mxnin/github-slideshow/trabalho_pmr3220/figuras/p1_gabarito_maquete.pdf

## PMR3220 – Grupo C – Gabarito 1:1 da maquete (imprimir em escala 100%)

escala: 100 mm

Elo CQ: 39.0 mm entre centros (furo Ø4,2)

Elo LN: 53.9 mm entre centros (furo Ø4,2)

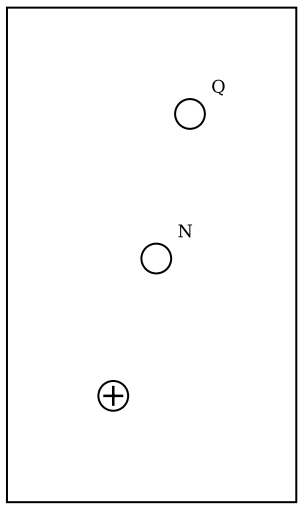
[picture p1: figure]

Placa distal da coxa (+ = origem da base 0)

Placa proximal da perna (+ = origem da base 4, ponto J)

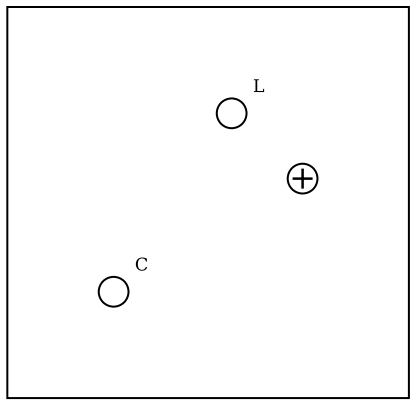
[picture p2: figure]

Coxa e perna nas dimensões medidas (coxa ≈ 375 mm; joelho–tornozelo ≈ 420 mm). Elos CQ e LN em planos diferentes (um de cada lado das placas).
