mxnin/github-slideshow/trabalho_pmr3220/main_parcial.tex

\documentclass[12pt,a4paper,twoside]{article}

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

\lstset{basicstyle=\ttfamily\footnotesize, breaklines=true, frame=single,
        literate={á}{{\'a}}1 {ã}{{\~a}}1 {é}{{\'e}}1 {ç}{{\c{c}}}1 {õ}{{\~o}}1 {í}{{\'i}}1 {ó}{{\'o}}1}

\input{dados/valores_parcial.tex}

\newcommand{\ve}[1]{\bm{#1}}
% --- notacao do metodo matricial (PMR3220) ---
\DeclareMathOperator{\sen}{sen}
\newcommand{\rv}[2]{{}^{#1}\mathbf{r}_{#2}}          % vetor posicao do ponto #2 na base #1
\newcommand{\rvd}[2]{{}^{#1}\dot{\mathbf{r}}_{#2}}
\newcommand{\rvdd}[2]{{}^{#1}\ddot{\mathbf{r}}_{#2}}
\newcommand{\vv}[2]{{}^{#1}\mathbf{v}_{#2}}
\newcommand{\Rmd}[2]{[{}^{#1}\dot R_{#2}]}             % derivadas da matriz de rotacao
\newcommand{\Rmdd}[2]{[{}^{#1}\ddot R_{#2}]}
\newcommand{\Et}{\tilde{\mathbf k}}                   % matriz antissimetrica de k no plano
\newcommand{\Rm}[2]{[{}^{#1}R_{#2}]}                 % matriz de rotacao
\newcommand{\Rot}[2]{\mathrm{Rot}(#1,\,#2)}
\newcommand{\Jm}[1]{[J_{#1}]}
\newcommand{\e}{\mathrm{e}}
\newcommand{\dd}{\,\mathrm{d}}
\newtheorem{hipotese}{Hipótese}
\captionsetup{font=small,labelsep=colon}
\numberwithin{equation}{section}

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

\pagenumbering{roman}
\listoffigures
\clearpage
\listoftables
\clearpage
\tableofcontents
\clearpage
\pagenumbering{arabic}
\setcounter{page}{5}

\section{Introdução}

O movimento do membro inferior humano resulta da interação entre diferentes segmentos
e articulações, sendo o joelho particularmente importante para a mobilidade entre a
coxa e a perna. Entretanto, seu movimento relativo não pode ser rigorosamente
representado por uma simples junta de revolução: no plano sagital, os côndilos
femorais rolam e deslizam sobre o platô tibial, de modo que o centro instantâneo de
rotação (CIR) descreve uma trajetória -- a \emph{centroide} -- em vez de permanecer fixo
\cite{menschik1974,oconnor1989,dathe2016}. Desde \textcite{menschik1974}, essa cinemática
é modelada por um quadrilátero articulado cruzado, formado pelas fibras isométricas
dos ligamentos cruzados anterior (LCA) e posterior (LCP) e pelos segmentos ósseos que
unem suas inserções \cite{oconnor1989,zavatsky1992}.

Nesse contexto, o projeto de próteses e órteses constitui uma aplicação relevante da
teoria de mecanismos, permitindo reproduzir ou auxiliar movimentos do membro inferior
em situações de amputação ou de comprometimento da capacidade motora. Este relatório
parcial trata da primeira etapa do trabalho: o projeto de uma prótese de joelho e
perna capaz de reproduzir o movimento relativo entre a coxa e o conjunto perna--pé por
meio de um quadrilátero articulado plano (\cref{fig:enunciado}). São apresentados a
fundamentação do modelo, a definição da geometria, a aquisição experimental do
movimento em um integrante do grupo e o processamento dos dados que servirá de base
para a síntese dimensional do mecanismo.

\begin{figure}[htbp]
  \centering
  
  \caption{Diagrama cinemático do enunciado: pivôs $C$ e $L$ na coxa e $Q$ e $N$ na perna.}
  \label{fig:enunciado}
\end{figure}

\section{Objetivos}

\begin{itemize}
  \item Desenvolver a síntese dimensional de um mecanismo quadrilátero articulado,
  capaz de reproduzir de forma aproximada o movimento relativo entre a coxa e o
  conjunto perna--pé de uma prótese de membro inferior.
  \item Determinar as dimensões e as posições das articulações do mecanismo, utilizando
  como referência as posições do membro inferior obtidas experimentalmente.
  \item Realizar a análise cinemática de uma órtese para membro inferior, determinando
  as posições, velocidades e acelerações angulares dos segmentos ao longo de um ciclo
  de movimento.
  \item Realizar a análise dinâmica do sistema, determinando os torques necessários nos
  atuadores do joelho e da articulação entre a coxa e o tronco para a execução do
  movimento considerado.
\end{itemize}

Neste relatório parcial são desenvolvidas as etapas preparatórias do primeiro e do
segundo objetivos: a formulação do modelo do quadrilátero e a obtenção, a partir das
medições, do movimento relativo entre a coxa e a perna.

\section{Fundamentação teórica}\label{cap:teoria1}

\subsection{Notação}\label{sec:notacao}

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

\subsection{Síntese do tipo e mobilidade: o quadrilátero articulado}

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

No joelho protético (\cref{fig:enunciado}) o elo fixo é a coxa (pivôs $C$ e $L$),
as manivelas/balancins são $CQ$ e $LN$, e o \emph{acoplador} é a perna (pivôs $Q$ e $N$),
ao qual se fixa rigidamente o pé. Como o acoplador executa um movimento plano geral,
seu CIR relativo à coxa -- o polo $I_{13}$ -- é, pelo teorema de Aronhold--Kennedy, a
intersecção das retas $CQ$ e $LN$ e se desloca à medida que o joelho flexiona, tal como
no joelho natural \cite{norton2010,radcliffe1994}. Joelhos protéticos de quatro barras
exploram essa propriedade: com o CIR alto e posterior na extensão, obtém-se
estabilidade voluntária na fase de apoio; com o CIR migrando na flexão, obtém-se
encurtamento aparente da perna na fase de balanço \cite{radcliffe1994}.

A condição de Grashof classifica o tipo de movimento possível. Sendo $s$ e $l$ os
comprimentos do menor e do maior elo e $p$, $q$ os demais,
\begin{equation}
  s + l \le p + q \quad\Longrightarrow\quad \text{pelo menos um elo dá voltas completas.}
  \label{eq:grashof}
\end{equation}
Na prótese, a flexão útil está limitada a cerca de \SI{120}{\degree}; logo, um mecanismo
não Grashof (triplo balancim) é aceitável, desde que nenhuma configuração de ponto
morto ocorra dentro dessa faixa. A qualidade da transmissão de forças é avaliada pelo
ângulo de transmissão $\mu$ -- ângulo agudo entre o acoplador e o balancim de saída --,
recomendando-se $\mu \ge \SI{30}{\degree}$ \cite{norton2010}.

\subsection{Bases e análise de posição do quadrilátero (cadeia fechada)}\label{sec:cadeia_fechada}

A \cref{fig:quadrilatero} mostra as bases adotadas, seguindo a convenção da
\cref{sec:notacao}. A base $0$ (fixa) está presa à coxa, com origem no centro do joelho em
extensão, $X_0$ para a frente (anterior) e $Y_0$ para cima (proximal). As bases $1$, $2$ e $3$
estão presas, respectivamente, ao elo $CQ$ (origem em $C$, $X_1$ ao longo de $CQ$), ao
acoplador (origem em $Q$, $X_2$ ao longo de $QN$) e ao elo $LN$ (origem em $L$, $X_3$ ao longo
de $LN$). A base $4$ também está presa à perna, com origem no ponto de referência do
joelho e $Y_4$ ao longo do eixo da perna (é a base em que se fazem as medições). Os
comprimentos são $\ell_0 = \overline{CL}$, $\ell_1 = \overline{CQ}$, $\ell_2 = \overline{QN}$ e
$\ell_3 = \overline{LN}$.

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

As matrizes de rotação e as origens das bases são
\begin{gather}
  \Rm{0}{1} = \begin{bmatrix} c_1 & -s_1 \\ s_1 & c_1 \end{bmatrix},\quad
  \Rm{1}{2} = \begin{bmatrix} c_2 & -s_2 \\ s_2 & c_2 \end{bmatrix},\quad
  \Rm{0}{3} = \begin{bmatrix} c_3 & -s_3 \\ s_3 & c_3 \end{bmatrix},\\
  \rv{0}{O_1} = \rv{0}{C},\qquad \rv{1}{O_2} = \begin{bmatrix} \ell_1 \\ 0 \end{bmatrix},\qquad \rv{0}{O_3} = \rv{0}{L},
\end{gather}
com $\rv{2}{N} = [\ell_2\ \ 0]^{\mathsf T}$ e $\rv{3}{N} = [\ell_3\ \ 0]^{\mathsf T}$. O ponto $N$ pertence
simultaneamente ao ramo $0\text{--}1\text{--}2$ e ao ramo $0\text{--}3$ da cadeia. Pelo ramo
$0\text{--}1\text{--}2$, aplica-se \eqref{eq:cadeia} de dentro para fora:
\begin{align*}
  \rv{1}{N} &= \rv{1}{O_2} + \Rm{1}{2}\,\rv{2}{N}
            = \begin{bmatrix} \ell_1 \\ 0 \end{bmatrix} + \begin{bmatrix} c_2 & -s_2 \\ s_2 & c_2 \end{bmatrix}\begin{bmatrix} \ell_2 \\ 0 \end{bmatrix}
            = \begin{bmatrix} \ell_1 + \ell_2 c_2 \\ \ell_2 s_2 \end{bmatrix},\\
  \rv{0}{N} &= \rv{0}{C} + \Rm{0}{1}\,\rv{1}{N}
            = \begin{bmatrix} {}^0x_C + \ell_1 c_1 + \ell_2(c_1c_2 - s_1s_2) \\ {}^0y_C + \ell_1 s_1 + \ell_2(s_1c_2 + c_1s_2) \end{bmatrix},
\end{align*}
e as identidades $c_1c_2 - s_1s_2 = c_{12}$ e $s_1c_2 + c_1s_2 = s_{12}$ simplificam o resultado. Pelo
ramo $0\text{--}3$, $\rv{0}{N} = \rv{0}{L} + \Rm{0}{3}\,\rv{3}{N}$. Igualando os dois ramos, obtém-se a
\emph{equação de fechamento}
\begin{equation}
  \rv{0}{C} + \Rm{0}{1}\Big(\rv{1}{O_2} + \Rm{1}{2}\,\rv{2}{N}\Big) = \rv{0}{L} + \Rm{0}{3}\,\rv{3}{N}
  \;\Longrightarrow\;
  \begin{bmatrix} {}^0x_C + \ell_1 c_1 + \ell_2 c_{12} \\ {}^0y_C + \ell_1 s_1 + \ell_2 s_{12} \end{bmatrix}
  = \begin{bmatrix} {}^0x_L + \ell_3 c_3 \\ {}^0y_L + \ell_3 s_3 \end{bmatrix}.
  \label{eq:fechamento}
\end{equation}
Na prótese, a variável de entrada é a orientação da perna, $\psi = \theta_1 + \theta_2$
(ângulo de $X_2$ em relação a $X_0$), e as incógnitas são $\mathbf q = [\theta_1\ \ \theta_3]^{\mathsf T}$.
Passando todos os termos de \eqref{eq:fechamento} para um lado, com $c_{12} = \cos\psi$ e
$s_{12} = \sen\psi$ conhecidos,
\begin{equation*}
  \mathbf f(\mathbf q) =
  \begin{bmatrix} {}^0x_C + \ell_1 c_1 + \ell_2\cos\psi - {}^0x_L - \ell_3 c_3 \\
                  {}^0y_C + \ell_1 s_1 + \ell_2\sen\psi - {}^0y_L - \ell_3 s_3 \end{bmatrix} = \mathbf 0 ,
\end{equation*}
cujas derivadas parciais em relação a $\theta_1$ e $\theta_3$ formam a matriz jacobiana. A
solução é obtida pelo método de Newton--Raphson,
\begin{equation}
  \mathbf q^{(i+1)} = \mathbf q^{(i)} - [J]^{-1}\,\mathbf f\big(\mathbf q^{(i)}\big),
  \qquad
  [J] = \frac{\partial\mathbf f}{\partial\mathbf q} =
  \begin{bmatrix} -\ell_1 s_1 & \ell_3 s_3 \\ \ell_1 c_1 & -\ell_3 c_3 \end{bmatrix},
  \label{eq:newton}
\end{equation}
partindo da solução do passo anterior, o que mantém o mecanismo no mesmo ramo de
montagem. Como $\det[J] = \ell_1\ell_3\,\sen(\theta_1 - \theta_3)$, a matriz é singular quando
$CQ \parallel LN$ (polo no infinito). Uma vez conhecidos $\theta_1$ e $\theta_3$, o polo
$I_{13}$ (CIR da perna em relação à coxa) é a intersecção dos eixos $X_1$ e $X_3$,
\begin{equation}
  \rv{0}{I} = \rv{0}{C} + \lambda\begin{bmatrix} c_1\\ s_1\end{bmatrix} = \rv{0}{L} + \kappa\begin{bmatrix} c_3\\ s_3\end{bmatrix},
\end{equation}
e o ângulo de transmissão é o ângulo agudo entre $X_2$ e $X_3$, $\mu = |\psi - \theta_3|$
(reduzido a $[0, \SI{90}{\degree}]$).

\section{Metodologia}\label{cap:metodos1}

\subsection{Definição da geometria do mecanismo}

Inicialmente, foi definida uma representação geométrica simplificada do membro
inferior humano, buscando preservar as principais características cinemáticas do
movimento da coxa, da perna e do pé. A coxa, a perna e o pé foram considerados como
elementos rígidos, representados pelas geometrias correspondentes às regiões do membro
inferior. Para representar o movimento relativo entre a coxa e a perna na região do
joelho, foi adotado um mecanismo quadrilátero articulado. A configuração adotada e a
identificação dos pontos utilizados no modelo são apresentadas na \cref{fig:geometria}.

\begin{figure}[htbp]
  \centering
  
  \caption{Geometria adotada para a representação do membro inferior.}
  \label{fig:geometria}
\end{figure}

Na representação adotada, os pontos 1 e 2 estão localizados na região do quadril,
enquanto os pontos 3 e 4 estão posicionados na extremidade inferior da coxa, próxima à
região do joelho. Para a perna, os pontos 5 e 6 estão localizados imediatamente abaixo
do joelho, enquanto os pontos 7 e 9 estão posicionados aproximadamente na região do
tornozelo. O ponto 8 está localizado entre os pontos 7 e 9, contribuindo para a
representação da conexão entre a perna e o pé. Por fim, os pontos 10 e 11 correspondem
às extremidades inferiores da representação do pé.

A escolha de um mecanismo quadrilátero articulado para representar o movimento do
joelho está relacionada à necessidade de reproduzir adequadamente o movimento relativo
observado entre a coxa e a perna. Uma representação mais simples, na qual a coxa e a
perna fossem consideradas elementos rígidos conectados diretamente por uma única junta
de revolução, permitiria descrever apenas uma rotação da perna em torno de um centro
fixo. Nesse caso, os pontos pertencentes à perna descreveriam trajetórias circulares em
relação à coxa, o que constitui uma aproximação limitada do movimento do joelho.

O emprego de um quadrilátero articulado permite obter o movimento relativo entre a
coxa e a perna a partir da combinação das rotações de seus diferentes elos. Dessa
forma, o centro instantâneo do movimento relativo entre os segmentos (o polo $I_{13}$ da
\cref{sec:cadeia_fechada}) pode variar durante a movimentação, permitindo reproduzir
trajetórias mais complexas do que aquelas obtidas por uma única junta de revolução.
Essa característica é particularmente relevante para o problema proposto, uma vez que
o movimento relativo entre a coxa e a perna não pode ser rigorosamente representado
apenas por uma junta de rotação.

A representação do pé por meio de uma geometria triangular foi adotada de maneira
análoga, buscando preservar sua extensão e sua orientação em relação à perna. Uma
representação por um único elemento rígido poderia descrever apenas a distância entre
dois pontos, sem representar simultaneamente diferentes pontos de referência
associados ao pé. A geometria triangular fornece, portanto, uma representação rígida
simplificada da região, possibilitando acompanhar sua posição e orientação durante o
movimento.

Embora os pontos utilizados na aquisição experimental tenham sido definidos próximos
aos vértices das regiões utilizadas na representação geométrica, a localização das
articulações do mecanismo não está necessariamente restrita a esses pontos
experimentais. Articulações localizadas no interior das regiões correspondentes à coxa
e à perna também podem ser consideradas durante a síntese, desde que sejam compatíveis
com a geometria e com o movimento desejado.

\subsection{Aquisição experimental do movimento}\label{sec:aquisicao}

Após a definição da geometria, foram realizadas medições experimentais com o objetivo
de obter as posições dos pontos de interesse ao longo do movimento do membro inferior.
Para isso, um integrante do grupo realizou o movimento com a própria perna, e foi
registrada uma sequência de vídeo com o membro observado lateralmente.

Foram consideradas três configurações principais para caracterizar o movimento. A
configuração inicial corresponde à posição em pé, na qual a coxa, a perna e o pé se
encontram aproximadamente alinhados. A configuração intermediária corresponde a uma
flexão da perna de aproximadamente \SI{90}{\degree} em relação à coxa, mantendo-se a
posição da coxa. Por fim, a configuração final corresponde à condição de maior flexão
observada durante o experimento, na qual a perna se aproxima da coxa. A sequência de
configurações observada durante o movimento é apresentada na \cref{fig:sequencia}.

\begin{figure}[htbp]
  \centering
  
  \caption{Sequência de configurações do membro inferior durante o movimento experimental.}
  \label{fig:sequencia}
\end{figure}

Para o processamento do vídeo foi empregado o software \emph{Tracker} \cite{tracker},
que permite acompanhar a posição de pontos específicos ao longo dos diferentes
\emph{frames} de uma gravação. Foram definidos pontos de referência próximos aos
vértices das regiões utilizadas na representação geométrica da coxa, da perna e do pé.
Esses pontos foram identificados e acompanhados individualmente ao longo do movimento,
permitindo obter suas coordenadas no plano da imagem em função do tempo. A numeração
dos pontos utilizada no rastreamento corresponde à geometria apresentada anteriormente
(\cref{fig:geometria}).

\begin{figure}[htbp]
  \centering
  
  \caption{Rastreamento dos pontos do membro inferior e obtenção das posições no software \emph{Tracker}.}
  \label{fig:tracker}
\end{figure}

A partir do rastreamento, o \emph{Tracker} forneceu as coordenadas $x$ e $y$ dos pontos
acompanhados para os diferentes instantes analisados. Os valores obtidos correspondem,
portanto, às posições dos pontos no plano da imagem (base $im$, com a escala calibrada
em metros), e não diretamente aos comprimentos dos elos do mecanismo. O software também
permitiu visualizar graficamente a evolução temporal dessas coordenadas.

A planilha de dados obtida a partir do rastreamento contém as coordenadas dos onze
pontos para os \emph{frames} 234, 307, 390, 423, 456 e 561 (\cref{tab:tracker}, na
\cref{sec:anexos}). Para a análise do movimento, foram selecionados os \emph{frames}
307, 390, 423 e 456. O \emph{frame} 234 foi utilizado como referência durante a
identificação e numeração dos pontos, enquanto o \emph{frame} 561 foi desconsiderado,
pois corresponde a uma etapa do movimento em que houve auxílio manual para conduzir a
perna.

\subsection{Processamento dos dados}\label{sec:processamento}

As coordenadas do \emph{Tracker} estão na base da imagem. O que interessa ao quadrilátero
do joelho é apenas o movimento \emph{relativo} entre a coxa e a perna; por isso, o
movimento angular do quadril (a rotação da coxa em relação ao tronco, que também ocorre
levemente durante o experimento) foi desconsiderado, e a coxa foi tratada como o elo
fixo do mecanismo. Os dados foram processados em dois passos.

\paragraph{1º passo -- base da coxa em cada quadro.} A base $0$ tem origem no ponto médio
dos marcadores 3 e 4 (extremidade distal da coxa, junto ao joelho) e eixos paralelos aos
da imagem: $X_0$ horizontal, para a frente, e $Y_0$ vertical, para cima. Como a rotação do
quadril é desconsiderada, $\Rm{im}{0} = \Rot{0}{z_0} = I$, e a base da coxa apenas
acompanha a translação da região do joelho entre os quadros. Com
$\rv{im}{O_0} = \tfrac12\big(\rv{im}{3} + \rv{im}{4}\big)$, a mudança de base inversa de
\eqref{eq:mudancabase} fornece as coordenadas de cada marcador $k$ na base da coxa:
\begin{equation}
  \rv{0}{k} = \Rm{im}{0}^{\mathsf T}\big(\rv{im}{k} - \rv{im}{O_0}\big) = \rv{im}{k} - \tfrac12\big(\rv{im}{3} + \rv{im}{4}\big).
\end{equation}
Os marcadores 1 e 2 (quadril) não entram no processamento.

\paragraph{2º passo -- orientação da perna e flexão do joelho.} A perna é representada pelo
segmento que vai do ponto $J$, médio dos marcadores 5 e 6 (logo abaixo do joelho), ao
ponto $P$, marcador 8 (conexão perna--pé). Na base da coxa, sua orientação é
\begin{equation}
  \beta_j = \operatorname{atan2}\big({}^0y_P - {}^0y_J,\ {}^0x_P - {}^0x_J\big),
\end{equation}
e a flexão do joelho no quadro $j$ é medida em relação ao quadro 307 (membro estendido):
\begin{equation}
  \varphi_j = \beta_{307} - \beta_j \pmod{\SI{360}{\degree}} .
\end{equation}

\begin{table}[htbp]
  \centering
  \caption{Posição da perna na base $0$ (coxa) obtida das medições (mm): ponto $J$ (abaixo
  do joelho), ponto $P$ (tornozelo) e comprimento $\overline{JP}$. $\dagger$: quadro não
  utilizado na análise.}
  \label{tab:poses}
  \begin{tabular}{lrrrrrr}
    \toprule
    Quadro & $\varphi$ (\si{\degree}) & ${}^0x_{J}$ & ${}^0y_{J}$ & ${}^0x_{P}$ & ${}^0y_{P}$ & $\overline{JP}$ \\
    \midrule
    \tabelaposes
    \bottomrule
  \end{tabular}
\end{table}

\begin{figure}[htbp]
  \centering
  
  \caption{Marcadores dos quadros selecionados escritos na base da coxa, com origem entre
  os pontos 3 e 4 ($\square$: coxa, $\circ$: perna, $\triangle$: pé; linha: segmento $JP$).}
  \label{fig:medicoes}
\end{figure}

Os quadros selecionados correspondem a flexões de \phiA, \phiB, \phiC{} e
\phiD\si{\degree} (\cref{tab:poses,fig:medicoes}), próximas das configurações inicial
(\SI{0}{\degree}), intermediárias (cerca de \SI{45}{\degree} e \SI{90}{\degree}) e de
máxima flexão. O comprimento do segmento $JP$ varia apenas entre \pernamin{} e
\pernamax~mm, o que confirma a coerência da marcação ao longo do movimento (as
diferenças decorrem dos artefatos de pele e da marcação manual). Observa-se ainda que
o ponto $J$, logo abaixo do joelho, desloca-se cerca de \deslJ~mm em relação à coxa entre
a extensão e a flexão máxima: a perna não gira em torno de um ponto fixo, o que
confirma que uma junta de revolução simples não reproduz o movimento e motiva o uso do
quadrilátero articulado.

\section{Conclusões}

Nesta etapa, foram definidos a geometria de representação do membro inferior e o
modelo do joelho protético como quadrilátero articulado, formulado pelo método
matricial. O movimento do membro de um integrante do grupo foi filmado e rastreado no
\emph{Tracker}, e os dados foram escritos na base da coxa, desconsiderando o movimento
angular do quadril. Os quatro quadros selecionados cobrem flexões do joelho de
\phiA{} a \phiD\si{\degree}, e o deslocamento de cerca de \deslJ~mm da região proximal
da perna em relação à coxa confirma que o movimento relativo não é uma rotação pura.

As próximas etapas são: a síntese dimensional do quadrilátero a partir das posições
medidas, a construção da maquete e a análise cinemática e dinâmica da órtese.

\section{Materiais e anexos}\label{sec:anexos}

Os arquivos utilizados na aquisição e no tratamento dos dados experimentais são
disponibilizados juntamente com o relatório, incluindo o arquivo do projeto utilizado
no software \emph{Tracker}, a planilha com as coordenadas obtidas durante o rastreamento
e o programa em Python usado no processamento (\texttt{scripts/parte1\_parcial.py}).

\subsection{Dados experimentais obtidos pelo \emph{Tracker}}

A tabela a seguir apresenta as coordenadas cartesianas dos onze pontos rastreados para os
\emph{frames} registrados durante o experimento. Os valores correspondem diretamente aos
dados obtidos no arquivo de saída utilizado para a organização dos resultados
experimentais.

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

\clearpage
\printbibliography[heading=bibintoc,title={Referências}]

\end{document}
