mxnin/github-slideshow/trabalho_pmr3220/figuras/p1_erro_mu.pdf

### Ângulos nas articulações móveis

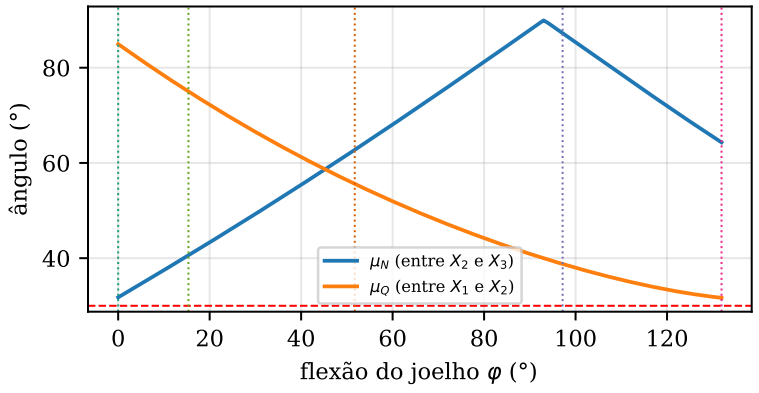
[picture p25: figure]
flexão do joelho φ (°); ângulo (°); (entre X2 e X3); (entre X1 e X2)
