mxnin/github-slideshow/autocad/joelho-4-barras/preview-A3.png

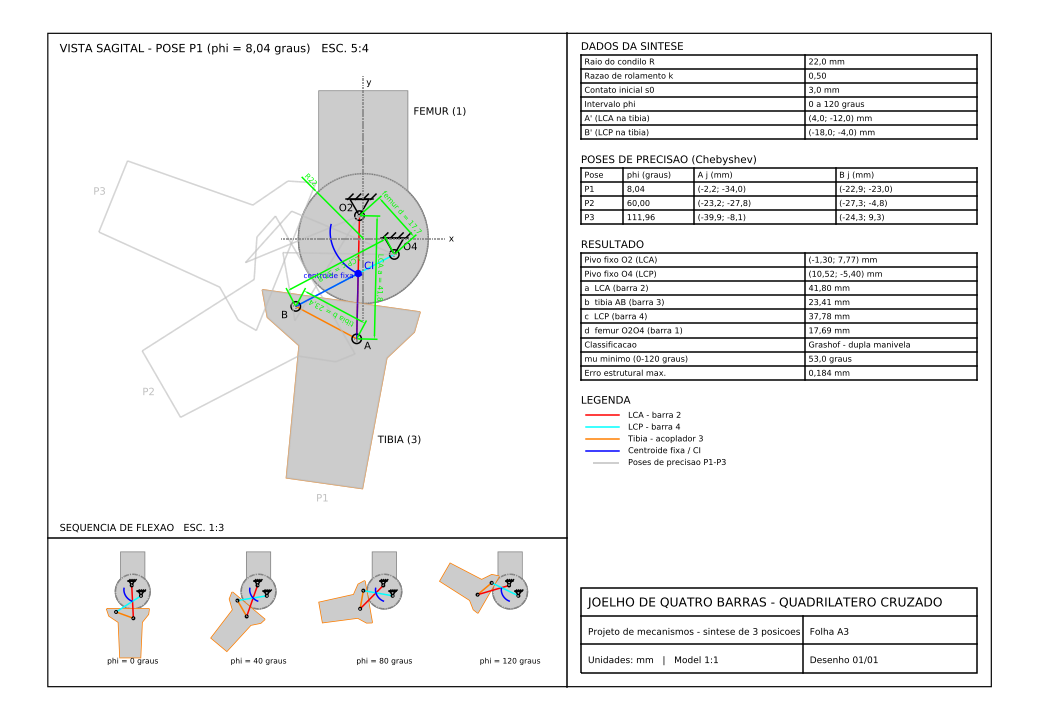
autocad/joelho-4-barras/preview-A3.png
