mxnin/github-slideshow/autocad/joelho-4-barras/joelho-4-barras.dxf

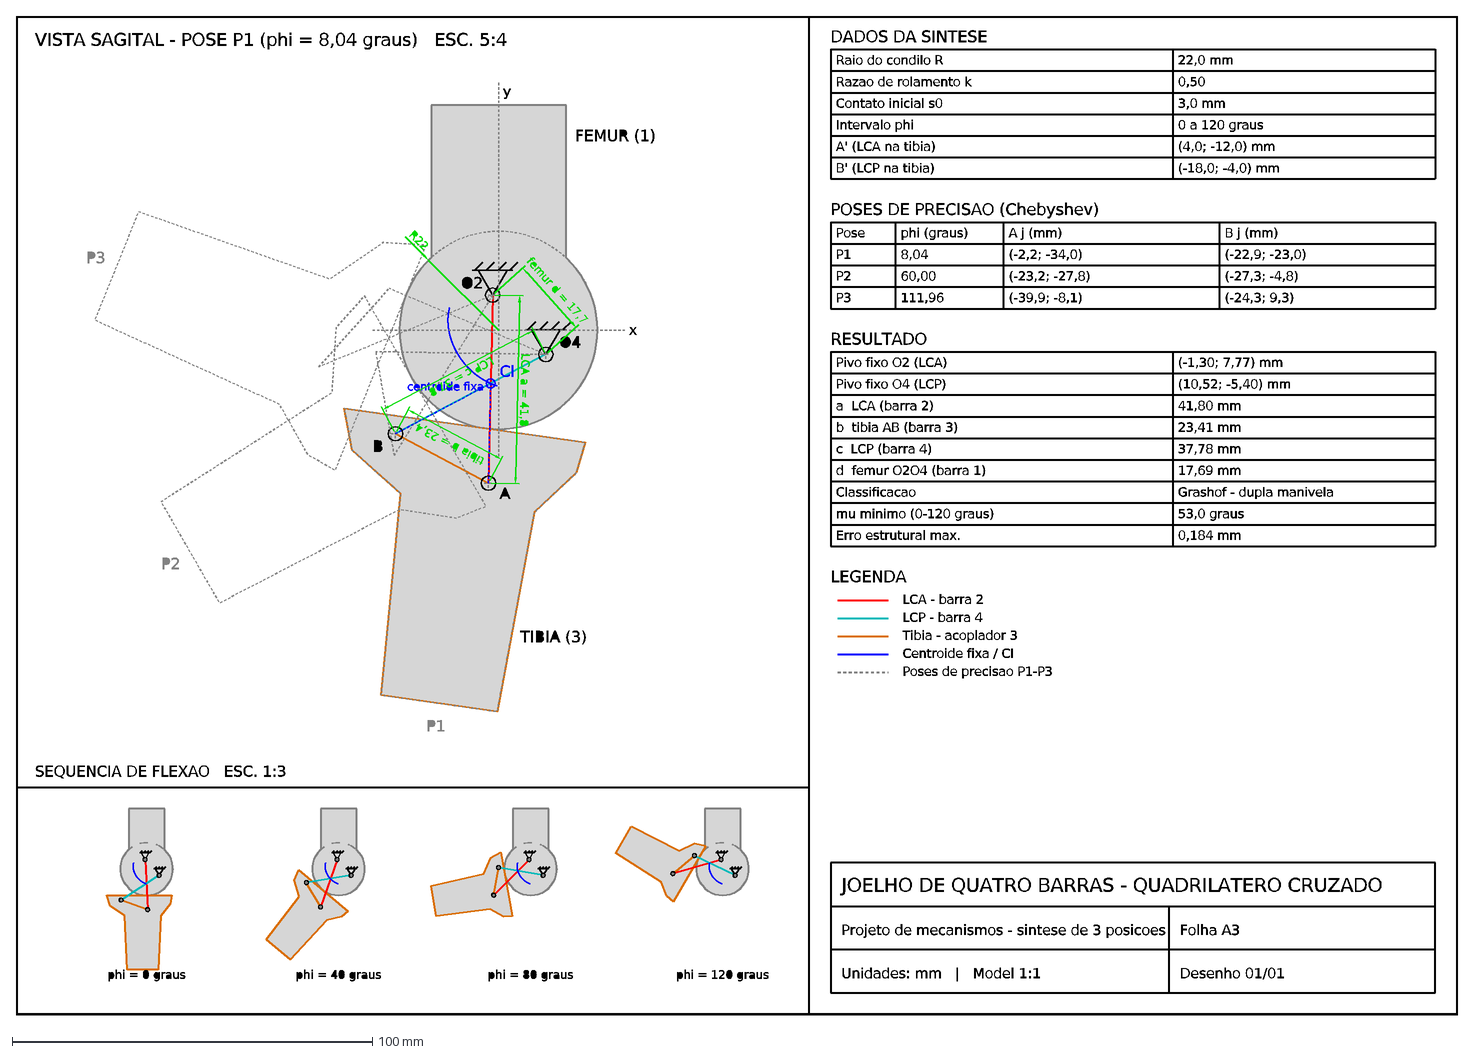
[picture p27: CAD file, 2026-10-03]
autocad/joelho-4-barras/joelho-4-barras.dxf
VISTA SAGITAL - POSE P1 (phi = 8,04 graus) ESC. 5:4
SEQUENCIA DE FLEXAO ESC. 1:3
DADOS DA SINTESE
Raio do condilo R
22,0 mm
Razao de rolamento k
0,50
Contato inicial s0
3,0 mm
Intervalo phi
0 a 120 graus
A' (LCA na tibia)
(4,0; -12,0) mm
B' (LCP na tibia)
(-18,0; -4,0) mm
POSES DE PRECISAO (Chebyshev)
Pose
phi (graus)
A j (mm)
B j (mm)
P1
8,04
(-2,2; -34,0)
(-22,9; -23,0)
P2
60,00
(-23,2; -27,8)
(-27,3; -4,8)
P3
111,96
(-39,9; -8,1)
(-24,3; 9,3)
RESULTADO
Pivo fixo O2 (LCA)
(-1,30; 7,77) mm
Pivo fixo O4 (LCP)
(10,52; -5,40) mm
a LCA (barra 2)
41,80 mm
b tibia AB (barra 3)
23,41 mm
c LCP (barra 4)
37,78 mm
d femur O2O4 (barra 1)
17,69 mm
Classificacao
Grashof - dupla manivela
mu minimo (0-120 graus)
53,0 graus
Erro estrutural max.
0,184 mm
LEGENDA
LCA - barra 2
LCP - barra 4
Tibia - acoplador 3
Centroide fixa / CI
Poses de precisao P1-P3
JOELHO DE QUATRO BARRAS - QUADRILATERO CRUZADO
Projeto de mecanismos - sintese de 3 posicoes
Unidades: mm | Model 1:1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
