mxnin/github-slideshow/trabalho_pmr3220/figuras/p1_ajuste.pdf

−40 −30 −20 −100

−60 −50 −40 −30 −20

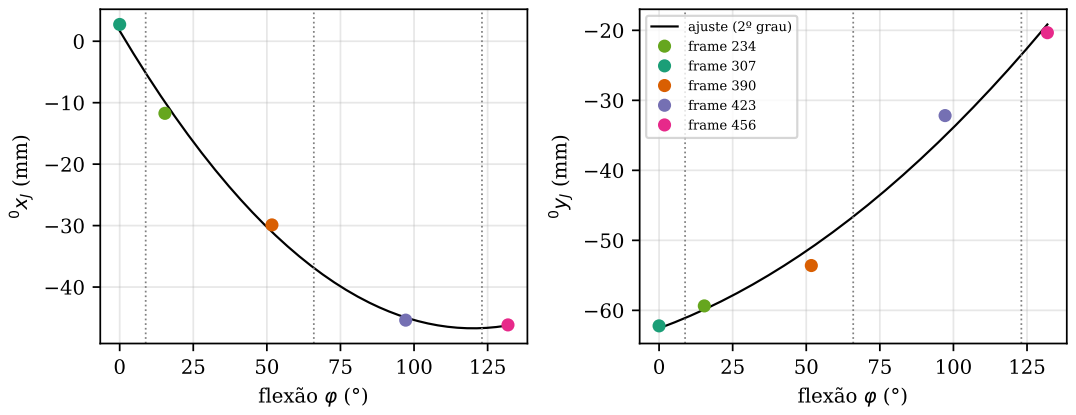
[picture p28: page 1]
125 flexão φ (°)

ajuste (2º grau)
frame 234 frame 307 frame 390

frame 423 frame 456
