mxnin/github-slideshow/trabalho_pmr3220/figuras/p2_torques_I.pdf

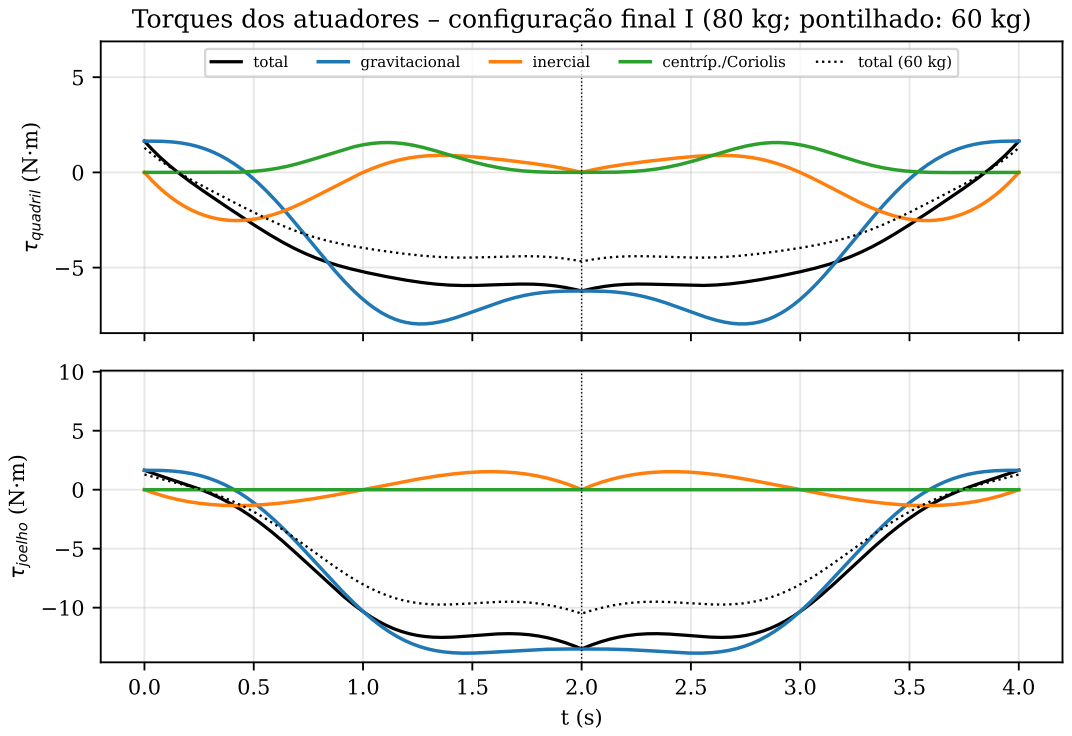
[picture p29: page 1]
τquadril (N·m); total; gravitacional; inercial; centríp./Coriolis; total (60 kg); τjoelho (N·m)

Torques dos atuadores – configuração final I (80 kg; pontilhado: 60 kg)
