mxnin/github-slideshow/trabalho_pmr3220/figuras/parcial_medicoes.pdf

200

400

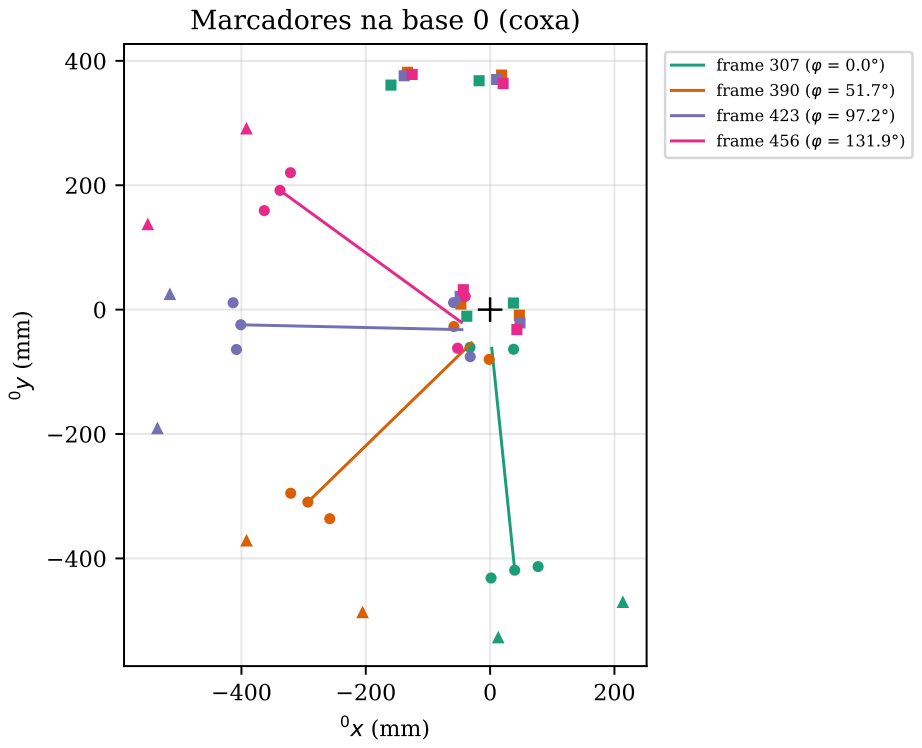
[picture p30: page 1]
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

Marcadores na base 0 (coxa)
