mxnin/github-slideshow/trabalho_pmr3220/figuras/p1_mecanismo.pdf

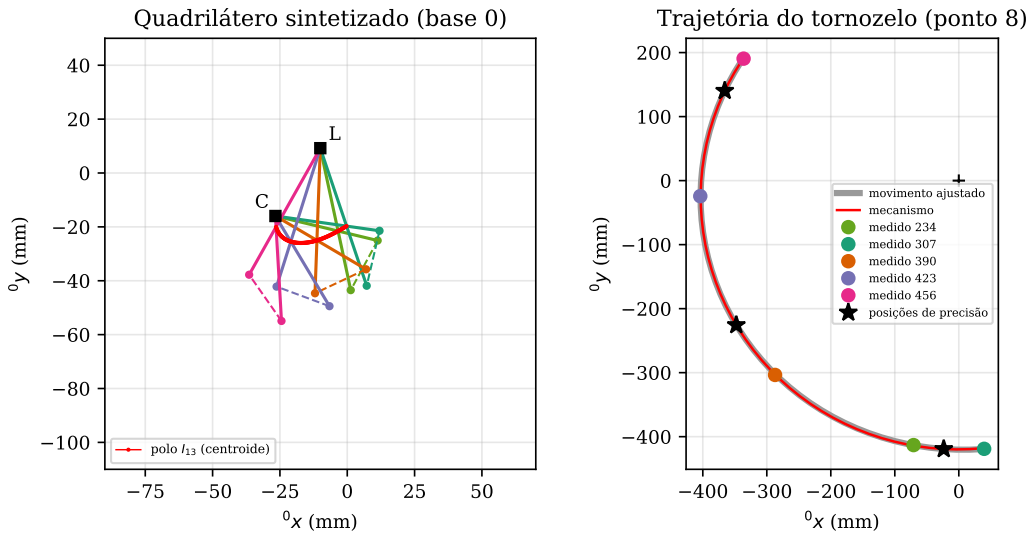
[picture p31: page 1]
polo I13 (centroide)

Quadrilátero sintetizado (base 0)

Trajetória do tornozelo (ponto 8)

movimento ajustado mecanismo medido 234 medido 307

medido 390 medido 423 medido 456

posições de precisão
