mxnin/github-slideshow/trabalho_pmr3220/figuras/p2_cinematica_I.pdf

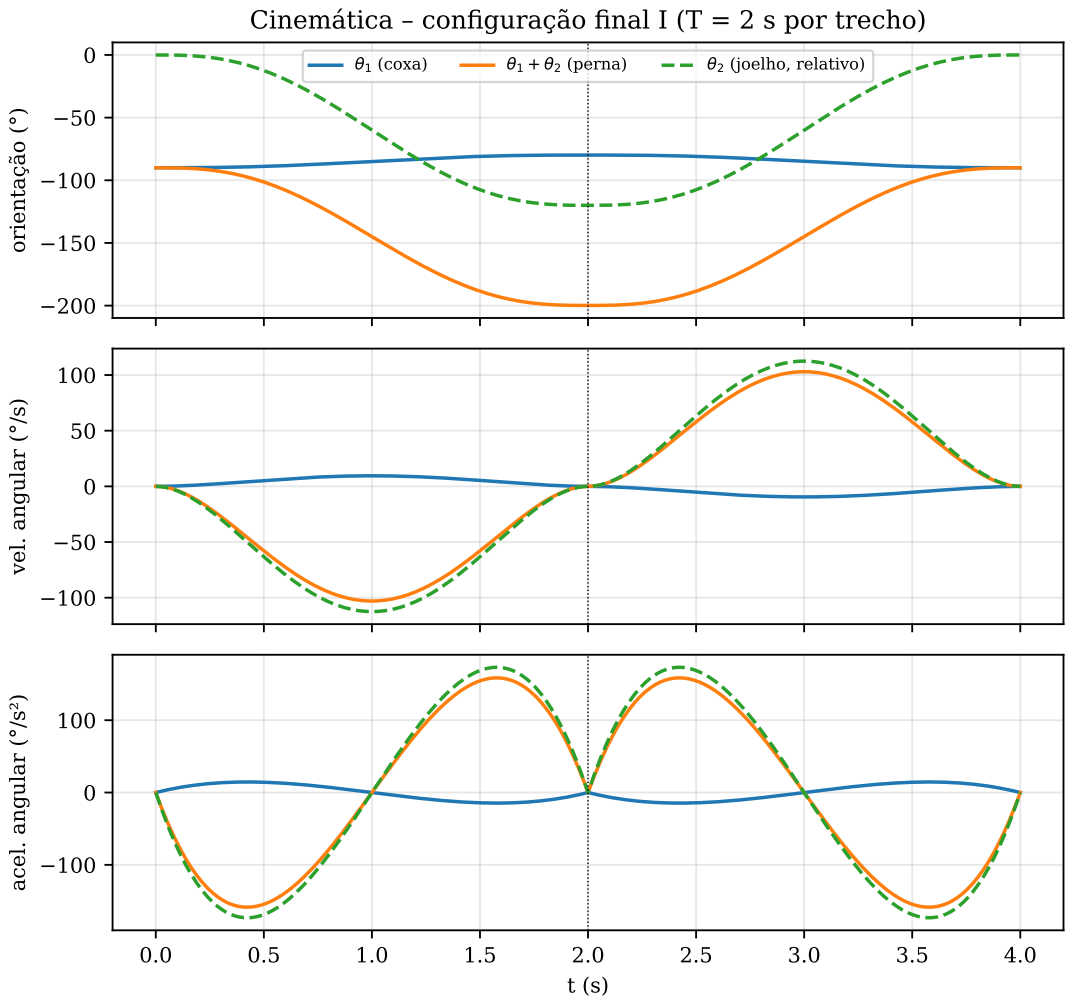
[picture p32: page 1]
orientação (°); θ1 (coxa); θ1 + θ2 (perna); θ2 (joelho, relativo); vel. angular (°/s)

Cinemática – configuração final I (T = 2 s por trecho)

acel. angular (°/s²)
