mxnin/github-slideshow/trabalho_pmr3220/figuras/p2_estrobo_I.pdf

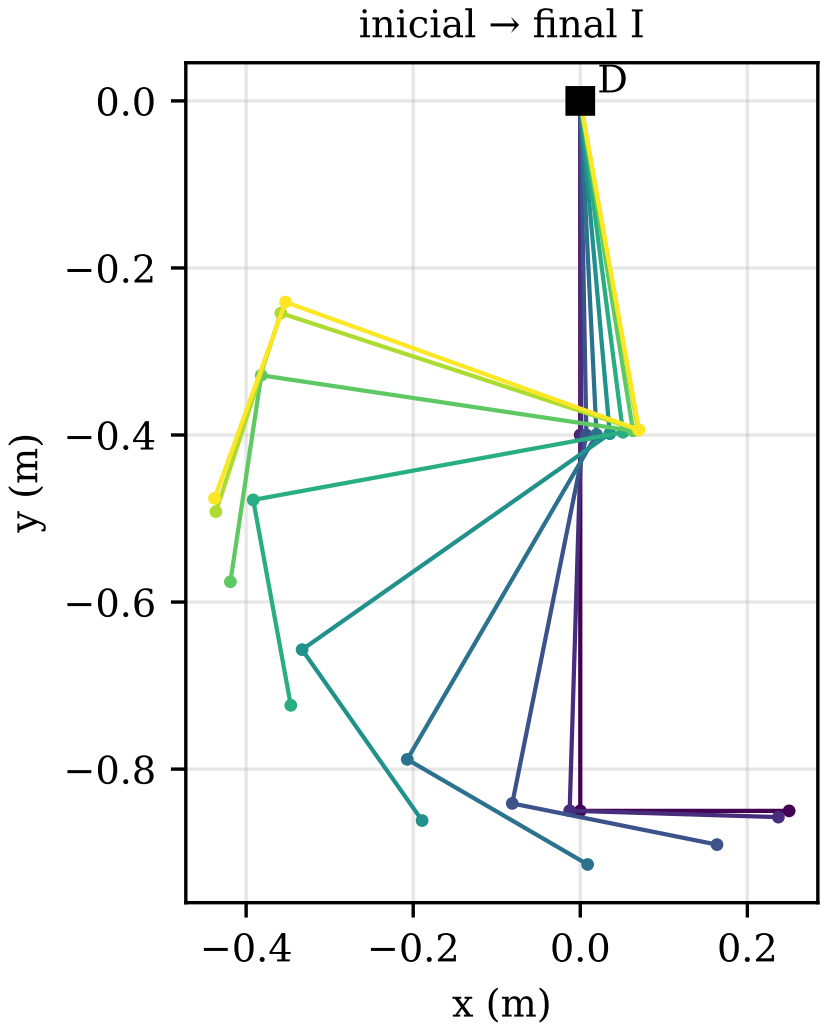
[picture p33: page 1]
inicial → final I
