mxnin/github-slideshow/trabalho_pmr3220/figuras/p2_estrobo_II.pdf

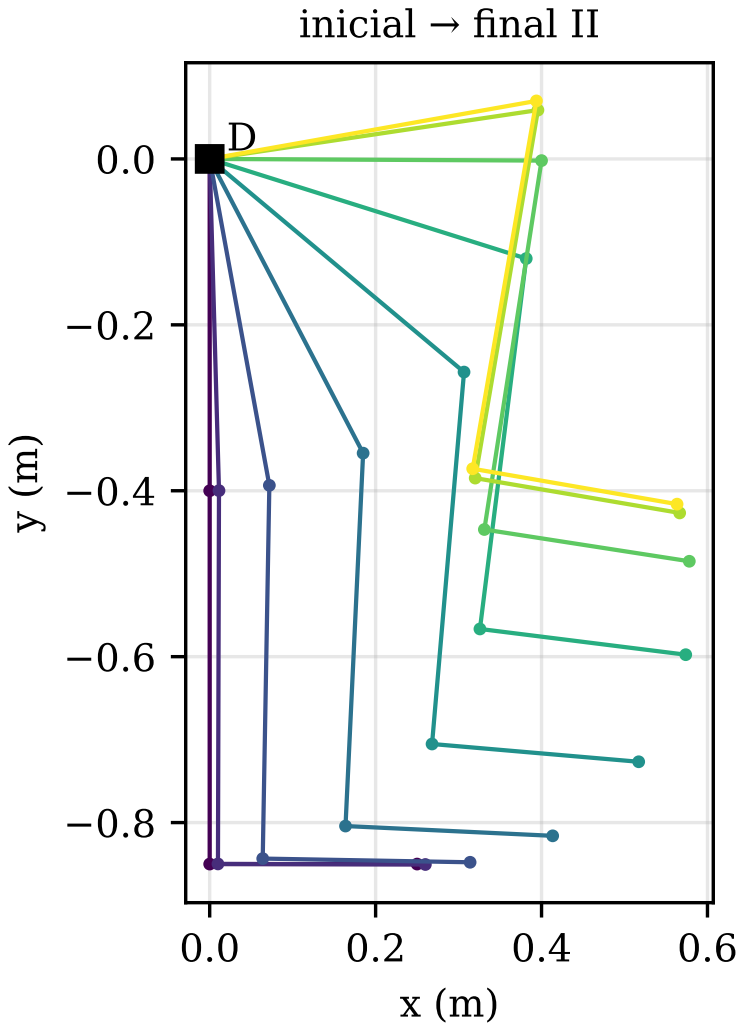
[picture p34: page 1]

inicial → final II
