mxnin/github-slideshow/(commit log)

2026-09-23 Add PMR3220 report: polycentric knee prosthesis and lower-limb orthosis
    LaTeX report with Python scripts: Part I synthesizes a four-bar knee from
    three precision positions (circumcenter method, optimized moving pivots,
    structural error, transmission angle, 1:1 model template); Part II builds
    quintic trajectories and computes hip/knee actuator torques via Lagrange,
    cross-checked with Newton-Euler, using Winter anthropometry and selected
    orthosis materials.
    Claude-Session: https://claude.ai/code/session_01BMMtHWhZG542ZqPJz3e2T4
    [poses_medidas.csv]
2026-09-23 Rewrite report math in the PMR3220 matrix-method notation
    Express kinematics with base-superscript vectors, homogeneous transforms
    (0T1 1T2, Rot(theta, z)), c1/s1/c12 abbreviations and relative joint
    angles, as in the course lectures. Part I now derives the four-bar loop
    closure 0T1 1T2 = 0T3 solved by Newton-Raphson; Part II derives velocities
    from T-dot products and the Lagrange mass matrix from CM Jacobians. Code
    follows the same notation (theta2 relative, b_x/b_y offsets, symbolic
    check via homogeneous matrices, Newton-Euler with skew matrices); all
    numerical results are unchanged.
    Claude-Session: https://claude.ai/code/session_01B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
2026-09-28 Expand report derivations step by step and add objectives section
    Show the intermediate steps of every derivation: the four-bar loop
    closure product and residual vector, the circumcenter system from the
    squared-distance equations, the two-step Procrustes solution, the quintic
    peak locations and a worked example, the Lagrange velocity and gravity
    terms, the Newton-Euler equations, and numeric substitutions for the
    Winter parameters, actuator sizing and Goodman check. Add an objectives
    and report-organization section to the introduction.
    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
2026-09-28 WIP: merge Group C draft and measured Tracker data into the report
    Rebuild main.tex in the draft's article format (cover, header/footer,
    section order) with the group's text, photos and Tracker table; rewrite
    Part I synthesis to use the measured marker data. Figures and the PDF
    are regenerated in the follow-up commit.
    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
    [poses_medidas.csv, tracker_rascunho.csv]
2026-09-28 Merge Group C draft with the full report and measured-data synthesis
    Report now follows the group's draft (cover, text, photos, Tracker
    table) and adds the theory, step-by-step derivations and Part II. Part I
    synthesis uses the measured frames 307/390/456 as precision positions
    and frame 423 for verification (2.5 mm ankle error, below the 7-16 mm
    marker residual). Fixes the cover logo transparency.
    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
2026-09-28 WIP: ignore hip rotation in Part I thigh frame
    The thigh is now the fixed link with image-aligned axes and origin at the
    midpoint of markers 3-4, so only the thigh/shank relative motion enters
    the four-bar synthesis. Results and PDF follow in the next commit.
    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
2026-09-28 WIP: regenerated measured poses (thigh without hip rotation)
    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
    [poses_medidas.csv]
2026-09-28 Fall back to unrounded pivots when rounded four-bar does not assemble
    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
2026-09-28 Resynthesize Part I with the thigh as fixed link (hip rotation ignored)
    Measured flexions become 0/50.7/96.4/130.9 deg. The new four-bar
    (links 20.0/28.3/26.5/35.4 mm) passes through frames 307/390/456 and
    misses the verification frame 423 by 0.34 mm, with transmission angle
    of at least 44.3 deg. Discussion and conclusions updated accordingly.
    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
2026-09-28 Add partial report PDF limited to Part I up to data processing
    main_parcial.tex keeps the cover, introduction, objectives, notation,
    four-bar fundamentals and loop closure, geometry, acquisition and data
    processing; it drops the precision-position synthesis, the Procrustes
    fit, synthesis results, model and all of Part II. Knee flexion is
    computed from the shank segment (markers 5-6 midpoint to 8) in the
    thigh frame by scripts/parte1_parcial.py.
    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
    [poses_parcial.csv]
2026-09-28 WIP: restrict math to course topics (dyad synthesis, Newton-Euler)
    Part I: two-point rigid-body pose, standard-dyad synthesis solved by
    Cramer's rule with a sweep of the free choices, Newton-Raphson position
    analysis, type synthesis via Gruebler. Part II: Newton-Euler replaces
    Lagrange; actuator sizing, fatigue check, RMS/power and T sensitivity
    removed as beyond the assignment. Final results follow.
    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
    [poses_medidas.csv]
2026-09-28 Finish course-only math revision and add Part I report
    Synthesis now uses the standard dyad with free choices chosen by sweep
    (frames 307/390/456, verification 423: 0.9 mm, mu >= 38.6 deg, moving
    pivots constrained to the proximal shank). Adds main_parteI.tex, built by
    scripts/monta_parteI.py, with Part I only.
    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
2026-09-30 WIP: replace homogeneous transforms with point change of basis
    All kinematics now use 0r = [0R1](1rO2 + [1R2] 2r) and derivatives of
    rotation matrices; the standard dyad is solved with 2x2 rotation blocks
    instead of complex numbers. Adds scripts/monta_parcial.py to rebuild the
    partial report from main.tex. Final PDFs follow.
    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
2026-10-01 Adiciona simulacao interativa da Parte I com bases e vetores
    Quadrilatero CQNL do Grupo C animado pela flexao, com as bases 0-4,
    as diades W, Z, U, S, os vetores de posicao e a mudanca de base de
    ponto 0r = [0R4] 4r + 0rO4 calculada ao vivo.
    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
2026-10-01 Parte I: refaz a sintese com dados suavizados e simulacao com bases solidarias
    - base 4 da perna passa a ter origem em J (ponto medio de 5-6), presa a perna
    - trajetoria medida de J suavizada por minimos quadrados (2o grau, quadros 234-456)
    - posicoes de precisao sobre a trajetoria ajustada com espacamento de Chebyshev
    - varredura de todas as diades e exigencia de mu >= 30 graus nas duas
    articulacoes moveis (Q e N), para o quadrilatero nao se dobrar
    - novo mecanismo: erro maximo 1,4 mm em relacao ao movimento ajustado e
    no maximo 2,4 mm aos tornozelos medidos
    - simulacao com as bases presas a cada peca e os vetores das diades
    Claud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
    [poses_medidas.csv]
2026-10-03 Adiciona desenho AutoCAD (DXF) do joelho de quatro barras
    Script Python (ezdxf) que refaz a síntese de três posições do rascunho
    e gera o DXF com camadas, cotas, poses de precisão, centroide e folha A3.
    Claude-Session: https://claude.ai/code/session_01YTSWcQq3se9FLfU3GSycnW
    [joelho-4-barras.dxf]
